Jeremy-Ngai-Sew-Poh/InkQuest-ESP32/easyeda/inkquest_pcb_layout.jpg

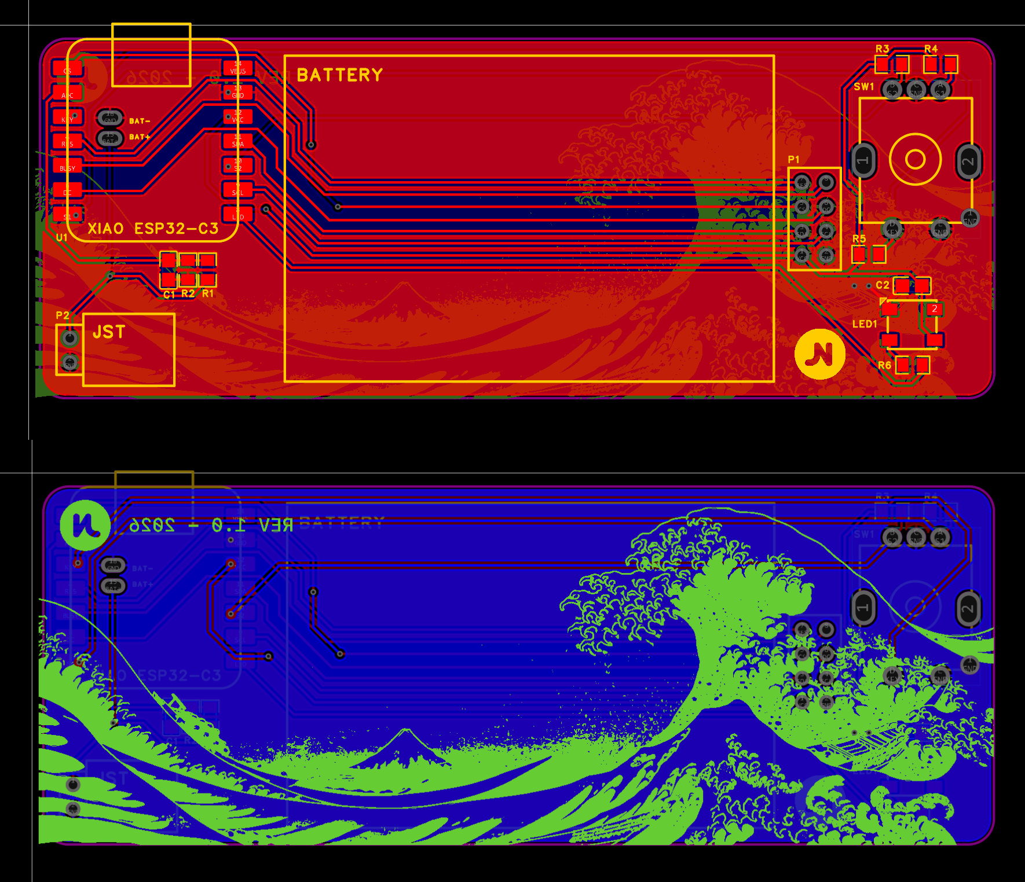
easyeda/inkquest_pcb_layout.jpg
