Jeremy-Ngai-Sew-Poh/InkQuest-ESP32/images/back_view.jpg

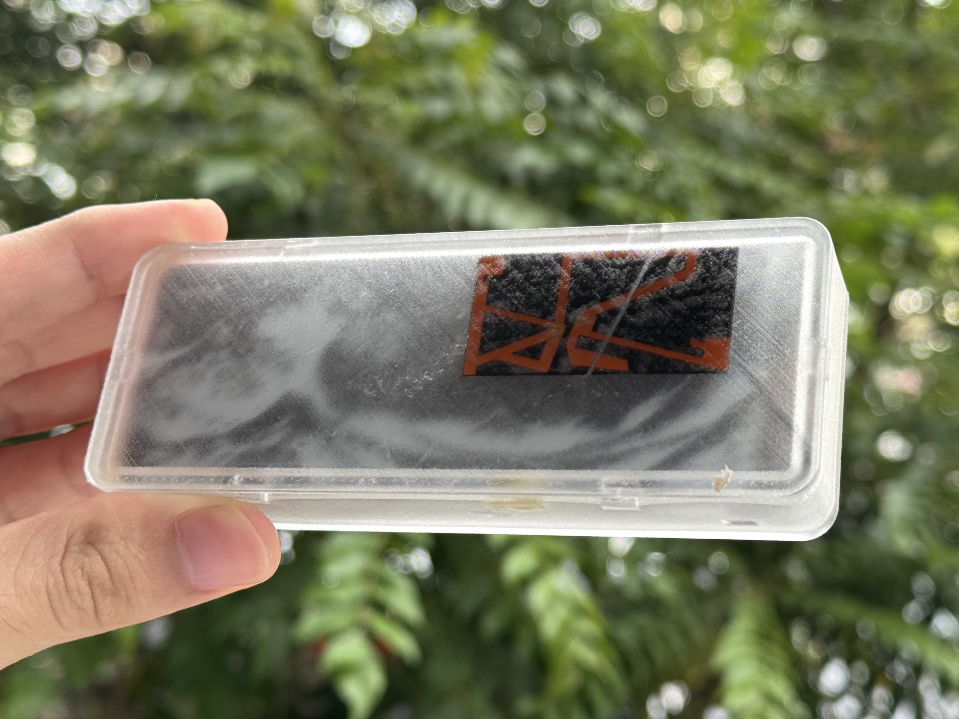
images/back_view.jpg
