Jeremy-Ngai-Sew-Poh/InkQuest-ESP32/images/demo_image.jpg

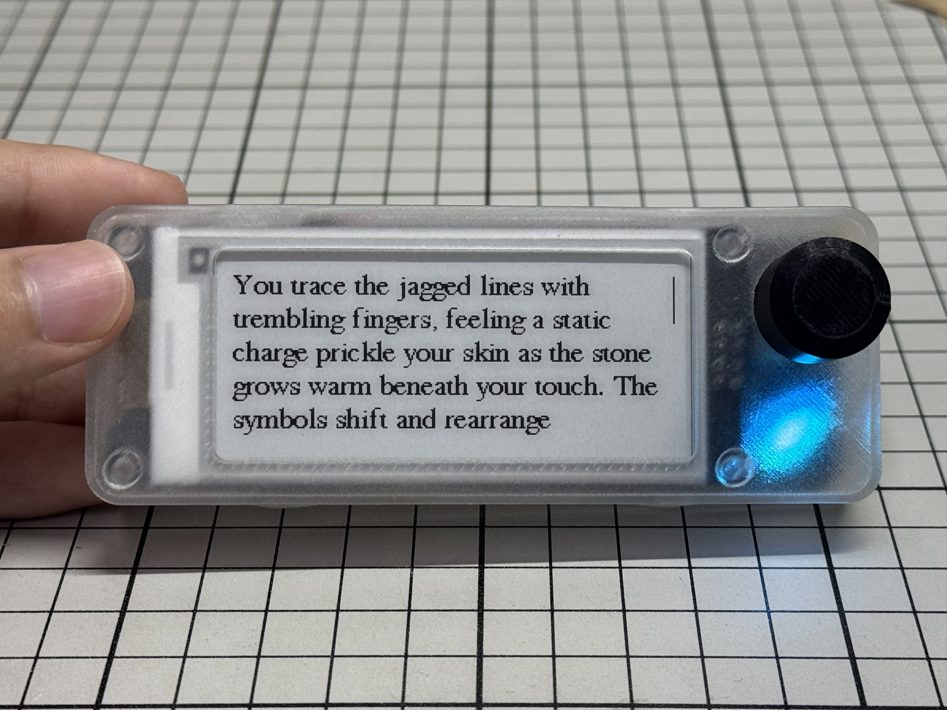
images/demo_image.jpg
