Jeremy-Ngai-Sew-Poh/InkQuest-ESP32/images/demo_loading_image.jpg

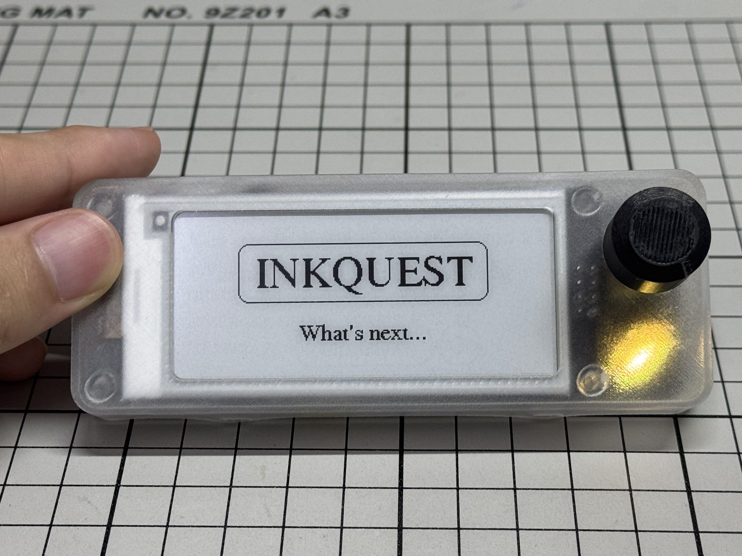
images/demo_loading_image.jpg
