Jeremy-Ngai-Sew-Poh/InkQuest-ESP32/BOM.csv

Component | Variation | Quantity | Link
XIAO ESP32-C3 | - | 1 | https://s.click.aliexpress.com/e/_c3WZulx7
WeAct 2.9inch E-Paper Display | 2.9 inch | 1 | https://s.click.aliexpress.com/e/_c3S1lFs5
603450 Li-Po Battery | - | 1 | https://s.click.aliexpress.com/e/_c4Fqa0KN
JST-PH Connector | 2P | 1 | https://s.click.aliexpress.com/e/_c3O6BO8p
Rotary Encoder EC11 | 20mm D shaft | 1 | https://s.click.aliexpress.com/e/_c4tUkbrx
WS2812B NeoPixel LED 5050 | - | 1 | https://s.click.aliexpress.com/e/_c3uFEcBJ
PH3.5 Low Profile Pin Connector | 2x4 Male, 2x4 Female | 2 | https://s.click.aliexpress.com/e/_c3FiCiEV
0805 Resistor | 1M | 2 | https://s.click.aliexpress.com/e/_c3coTfZX
0805 Resistor | 330 | 1 | https://s.click.aliexpress.com/e/_c3coTfZX
0805 Resistor | 10K | 3 | https://s.click.aliexpress.com/e/_c3coTfZX
0805 Ceramic Capacitor | 470nF | 1 | https://s.click.aliexpress.com/e/_c2I933x7
0805 Ceramic Capacitor | 100uF | 1 | https://s.click.aliexpress.com/e/_c2I933x7
