Jeremy-Ngai-Sew-Poh/InkQuest-ESP32/cad/inkquest_lid_print.stl

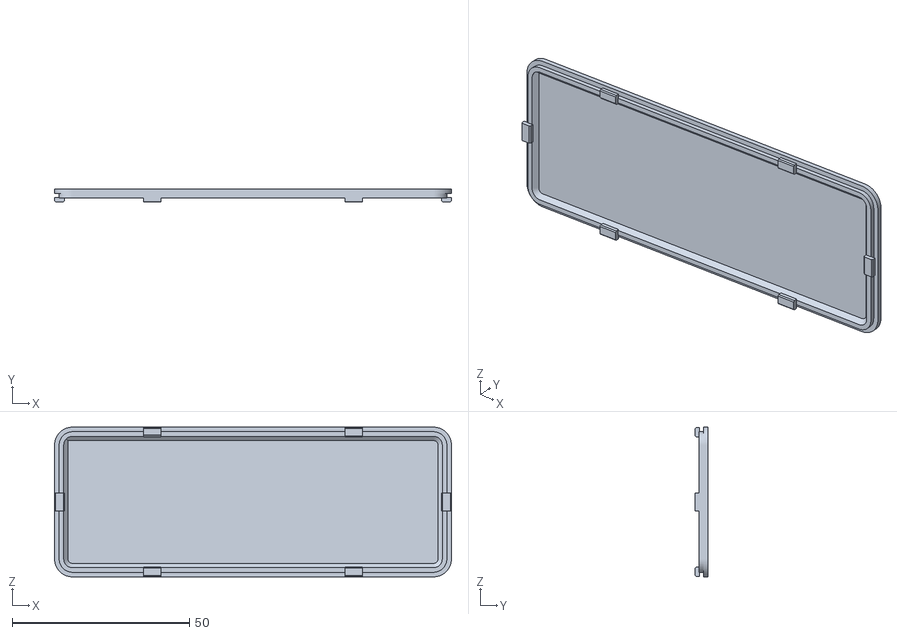
[picture p11: CAD file, 2026-10-28]
cad/inkquest_lid_print.stl
112.1 x 3.60 x 42.3
