Jeremy-Ngai-Sew-Poh/InkQuest-ESP32/cad/inkquest_enclosure_print.stl

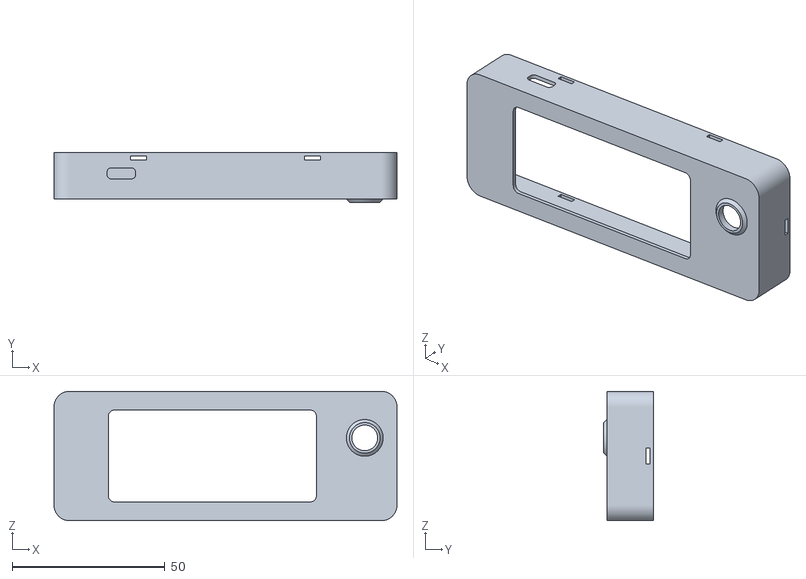
[picture p12: CAD file, 2026-10-28]
cad/inkquest_enclosure_print.stl
112.1 x 16.2 x 42.3
