Jeremy-Ngai-Sew-Poh/InkQuest-ESP32/(list of files, cad)

Other CAD files:
cad/inkquest_cad_assembly_final.step
cad/inkquest_cad_assembly_final.f3d
