Jeremy-Ngai-Sew-Poh/InkQuest-ESP32/(commit log)

2026-10-28 Create cad
2026-10-28 Upload PCB Gerber
2026-10-28 Add InkQuest 3D print files and assembly
    [inkquest_cad_assembly_final.step, inkquest_enclosure_print.stl, inkquest_lid_print.stl]
2026-10-28 Create BOM.csv with component details
    Added a Bill of Materials (BOM) with components and links.
    [BOM.csv]
2026-10-28 Update README with project details and BOM
    Added repository structure and bill of materials.
2026-10-28 Upload PCB schematics and layout
2026-10-28 Update README with CAD design and license details
    Added CAD design images and license information to README.
2026-10-28 Upload PCB image
2026-10-28 Add PCB Schematics section to README
    Added PCB schematics and images to the README.
2026-11-07 Update links in README
    Updated links for components in the Bill of Material section.
2026-11-07 Update BOM.csv with new components and links
    Updated component links and added new components.
    [BOM.csv]
